ytani01/NixieTubeClock_IN-16/README.md

# Nixie Tube Clock: IN-16

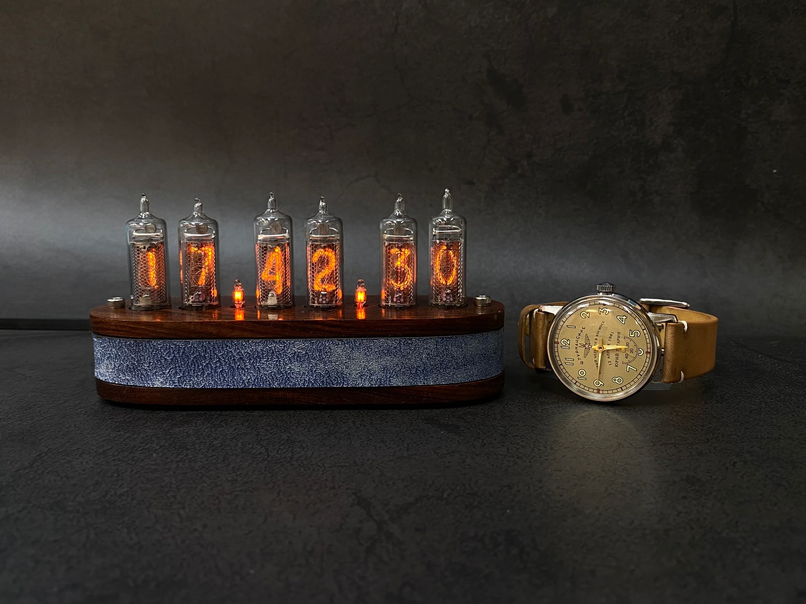
[picture p1: docs/figs/photo01.webp]


本物のニキシー管 IN-16 を使った置き時計です。
レトロな外界ですが、WiFi対応、OLED表示、エフェクトの切り替えなどの機能があります。

## ◆ 特徴

- WiFi対応で、インターネット(NTP)から常に正確な時刻を取得し、自動で時刻合わせします。
  - WiFiの設定は、スマートフォンから行います。
  - WiFiが使えないところでも、内部時計がバッテリーでバックアップされています。
- 底面に OLEDディスプレイがあり、WiFiの状態などを表示します。
- ニキシー管ならではの複数のエフェクトを切り替えることができます。
  (エフェクトなし、クロスフェード、フォグ(霧)、シャッフル)

### ◆ マニュアル

[マニュアル(PDF)](docs/Manual.pdf)

補足
- Reboot: [Button 0] + [Button 2]

## ◆ WiFi 設定

スマートフォンで、一旦、本機のアクセスポイントに接続してWiFiの設定を行います。

アクセスポイント名: NxClk_(固有のMACアドレス)

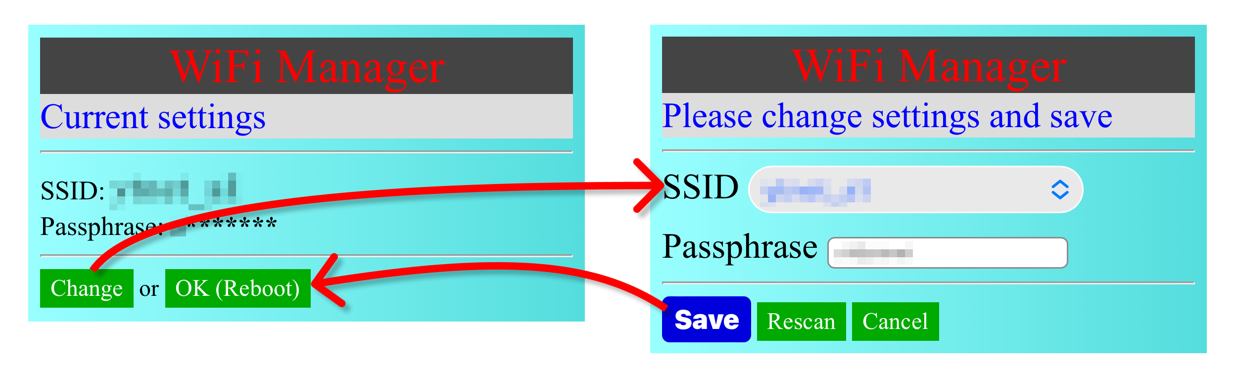
[picture p2: docs/figs/WiFi_Manager.png]
WiFi Manger


## ◆ OLED表示

### NTP
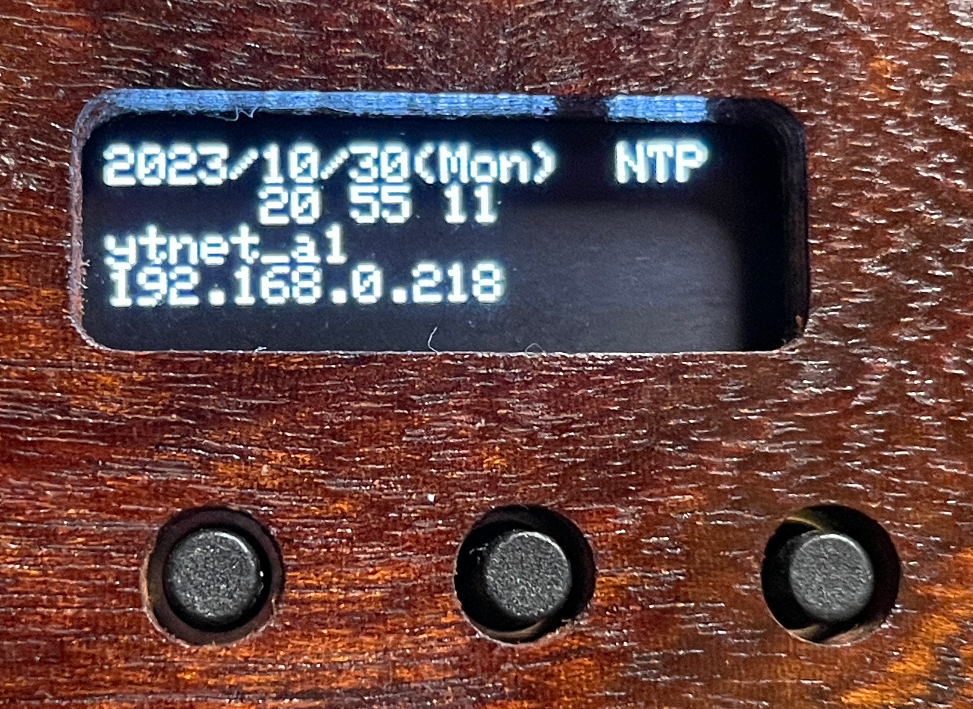
[picture p3: docs/figs/OLED-NTP.jpg]
OLED-NTP


### OLED: RTC
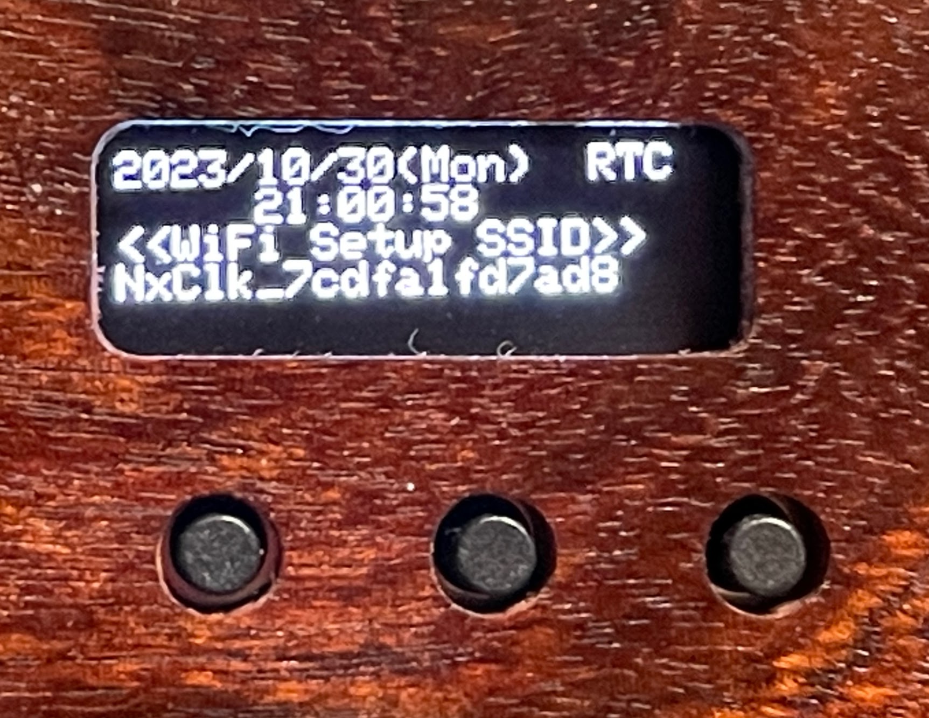
[picture p4: docs/figs/OLED-RTC.jpg]
OLED-RTC


## ◆ Effects

### Crossfade
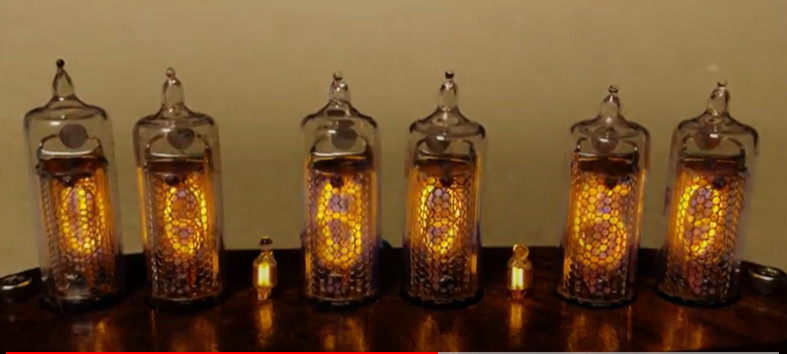
[picture p5: docs/movies/crossfade.jpg]
Crossfade (https://youtu.be/TvNmbtA_Buw?si=GQT42kCDqJkb_wn9)


### Fog
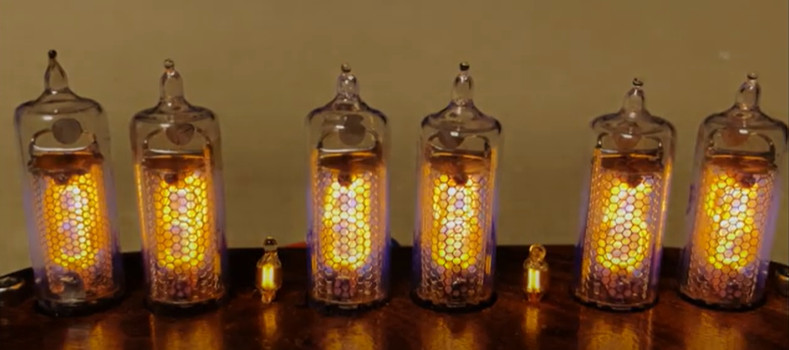
[picture p6: docs/movies/fog.jpg]
Fog (https://youtu.be/mSKaQIv3eQ8?si=7f47oo0_3DHgH0Qz)


### Shuffle
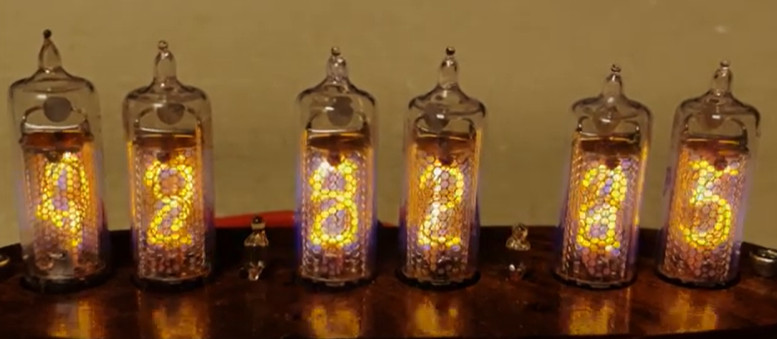
[picture p7: docs/movies/shuffle.jpg]
Shuffle (https://youtu.be/e5-Y6pX2xRI?si=2QsZdDAW-V6RgD0h)
