ytani01/NixieTubeClock_IN-16/references/fromTakao/IN-16_Nixie_Clock/drawing/IN-16_6digit_Nixie_Base.dxf

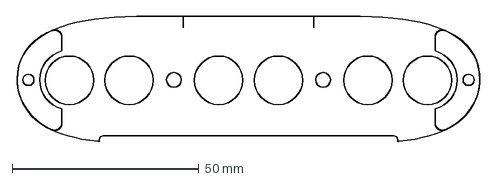
[picture p13: CAD file, 2023-10-02]
references/fromTakao/IN-16_Nixie_Clock/drawing/IN-16_6digit_Nixie_Base.dxf
124.5 x 33.5 mm
