ytani01/NixieTubeClock_IN-16/references/fromTakao/IN-16_Nixie_Clock/model/Spacer_3DPrint_Top_0817.stl

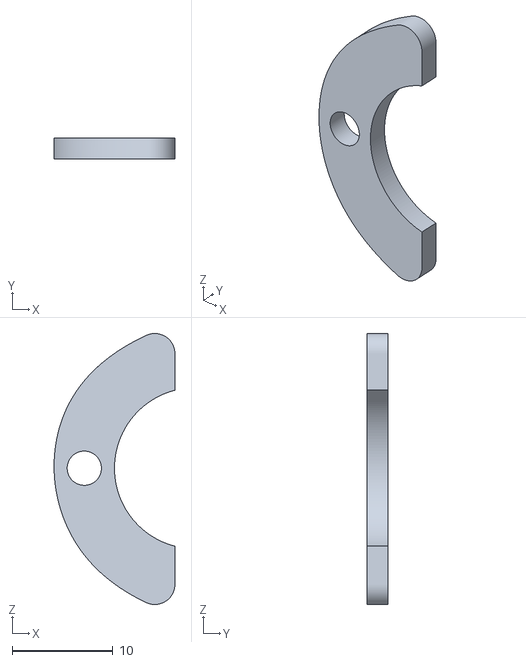
[picture p15: CAD file, 2023-10-02]
references/fromTakao/IN-16_Nixie_Clock/model/Spacer_3DPrint_Top_0817.stl
12.0 x 2.10 x 26.9
