ytani01/NixieTubeClock_IN-16/references/fromTakao/IN-16_Nixie_Clock/drawing/svg/Top_acrylic_0819.dxf

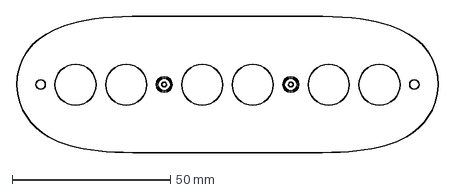
[picture p17: CAD file, 2023-10-02]
references/fromTakao/IN-16_Nixie_Clock/drawing/svg/Top_acrylic_0819.dxf
133.6 x 43.0 mm
