ytani01/NixieTubeClock_IN-16/references/fromTakao/IN-16_Nixie_Clock/drawing/Bottom_Rubber_Foot.dxf

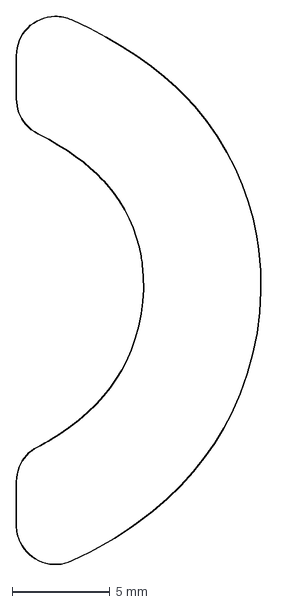
[picture p19: CAD file, 2023-10-02]
references/fromTakao/IN-16_Nixie_Clock/drawing/Bottom_Rubber_Foot.dxf
12.7 x 28.0 mm
