ytani01/NixieTubeClock_IN-16/references/fromTakao/IN-16_Nixie_Clock/model/Side_Wall_0817.stl

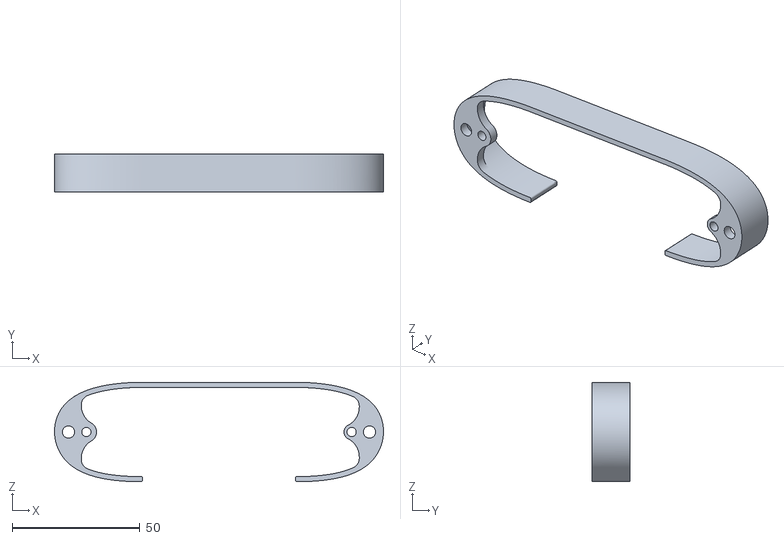
[picture p20: CAD file, 2023-10-02]
references/fromTakao/IN-16_Nixie_Clock/model/Side_Wall_0817.stl
129.0 x 15.0 x 39.0
