ytani01/NixieTubeClock_IN-16/references/fromTakao/IN-16_Nixie_Clock/drawing/IN-16_6digit_MCU_Base.dxf

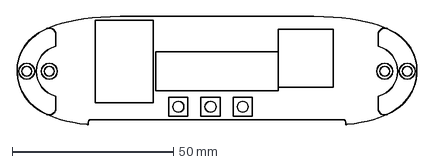
[picture p22: CAD file, 2023-10-02]
references/fromTakao/IN-16_Nixie_Clock/drawing/IN-16_6digit_MCU_Base.dxf
124.5 x 33.5 mm
