ytani01/NixieTubeClock_IN-16/references/fromTakao/IN-16_Nixie_Clock/drawing/header_placement_nixie.dxf

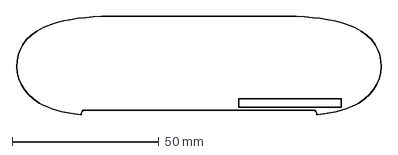
[picture p24: CAD file, 2023-10-02]
references/fromTakao/IN-16_Nixie_Clock/drawing/header_placement_nixie.dxf
124.5 x 33.5 mm
