ytani01/NixieTubeClock_IN-16/references/fromTakao/IN-16_Nixie_Clock/drawing/IN-16_6digit_PCB_drawing.dxf

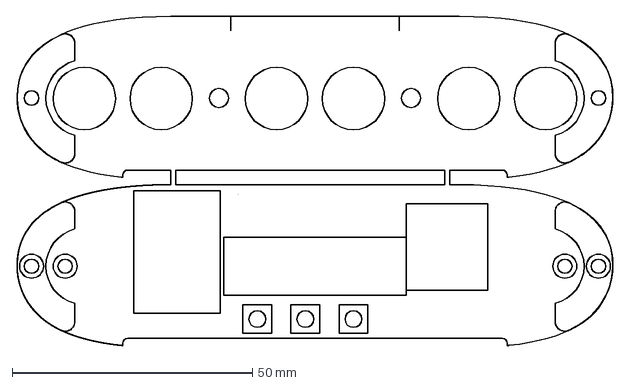
[picture p25: CAD file, 2023-10-02]
references/fromTakao/IN-16_Nixie_Clock/drawing/IN-16_6digit_PCB_drawing.dxf
124.5 x 68.5 mm
