ytani01/NixieTubeClock_IN-16/references/fromTakao/IN-16_Nixie_Clock/drawing/Bottom_Drawing_0827.dxf

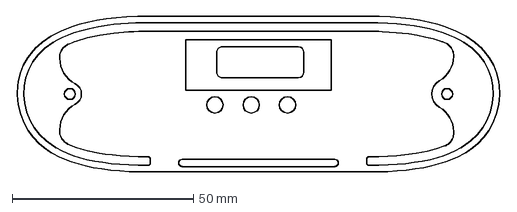
[picture p26: CAD file, 2023-10-02]
references/fromTakao/IN-16_Nixie_Clock/drawing/Bottom_Drawing_0827.dxf
133.6 x 43.0 mm
