ytani01/NixieTubeClock_IN-16/references/fromTakao/IN-16_Nixie_Clock/drawing/Side_wall_back.dxf

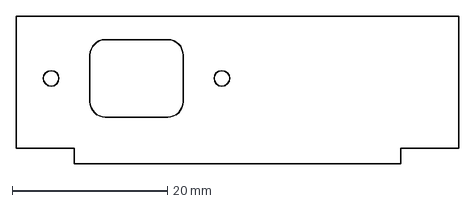
[picture p27: CAD file, 2023-10-02]
references/fromTakao/IN-16_Nixie_Clock/drawing/Side_wall_back.dxf
57.0 x 19.0 mm
