ytani01/NixieTubeClock_IN-16/references/fromTakao/IN-16_Nixie_Clock/drawing/Side_Wall_0824.stl

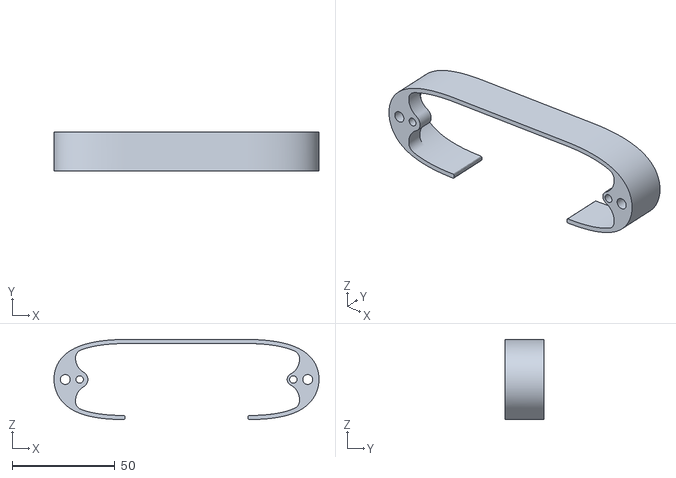
[picture p28: CAD file, 2023-10-02]
references/fromTakao/IN-16_Nixie_Clock/drawing/Side_Wall_0824.stl
129.0 x 19.0 x 39.0
