ytani01/NixieTubeClock_IN-16/references/fromTakao/IN-16_Nixie_Clock/drawing/lcd_typec_placement.dxf

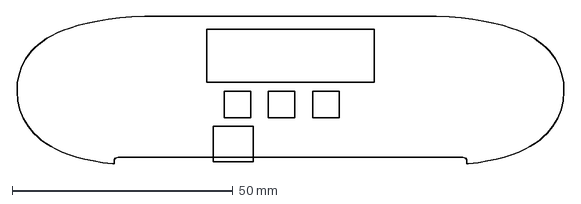
[picture p30: CAD file, 2023-10-02]
references/fromTakao/IN-16_Nixie_Clock/drawing/lcd_typec_placement.dxf
124.5 x 33.5 mm
