ytani01/NixieTubeClock_IN-16/references/fromTakao/IN-16_Nixie_Clock/drawing/Spacer_3DPrint_Mid_0824.stl

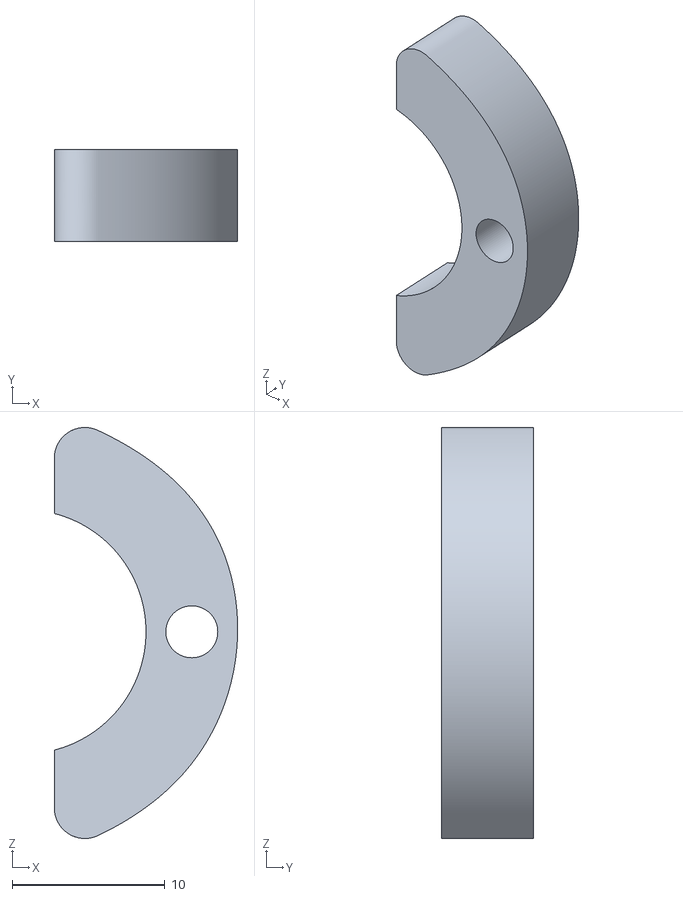
[picture p32: CAD file, 2023-10-02]
references/fromTakao/IN-16_Nixie_Clock/drawing/Spacer_3DPrint_Mid_0824.stl
12.0 x 6.00 x 26.9
