ytani01/NixieTubeClock_IN-16/(list of files, cad)

Other CAD files:
references/fromTakao/IN-16_Nixie_Clock/drawing/Spacer_3DPrint_Top_0824.stl
archives/references/fromTakao/IN-16_Nixie_Clock/drawing/Spacer_3DPrint_Top_0824.stl
