ytani01/NixieTubeClock_IN-16/tests/test02/README.md

# test01

- [ ] Serial: NG
- [x] log_i(): OK
- [x] buttons: OK
- [x] OLED: OK
- [ ] RTC
- [ ] WiFi
- [ ] Task
- [ ] Mode
- [ ] NixieTube
