ytani01/NixieTubeClock_IN-16/references/fromTakao/IN-16_Nixie_Clock/IN-16_Nixie_Clock.kicad_pcb

## KiCad design references/fromTakao/IN-16_Nixie_Clock/IN-16_Nixie_Clock.kicad_pcb (2023-10-02)

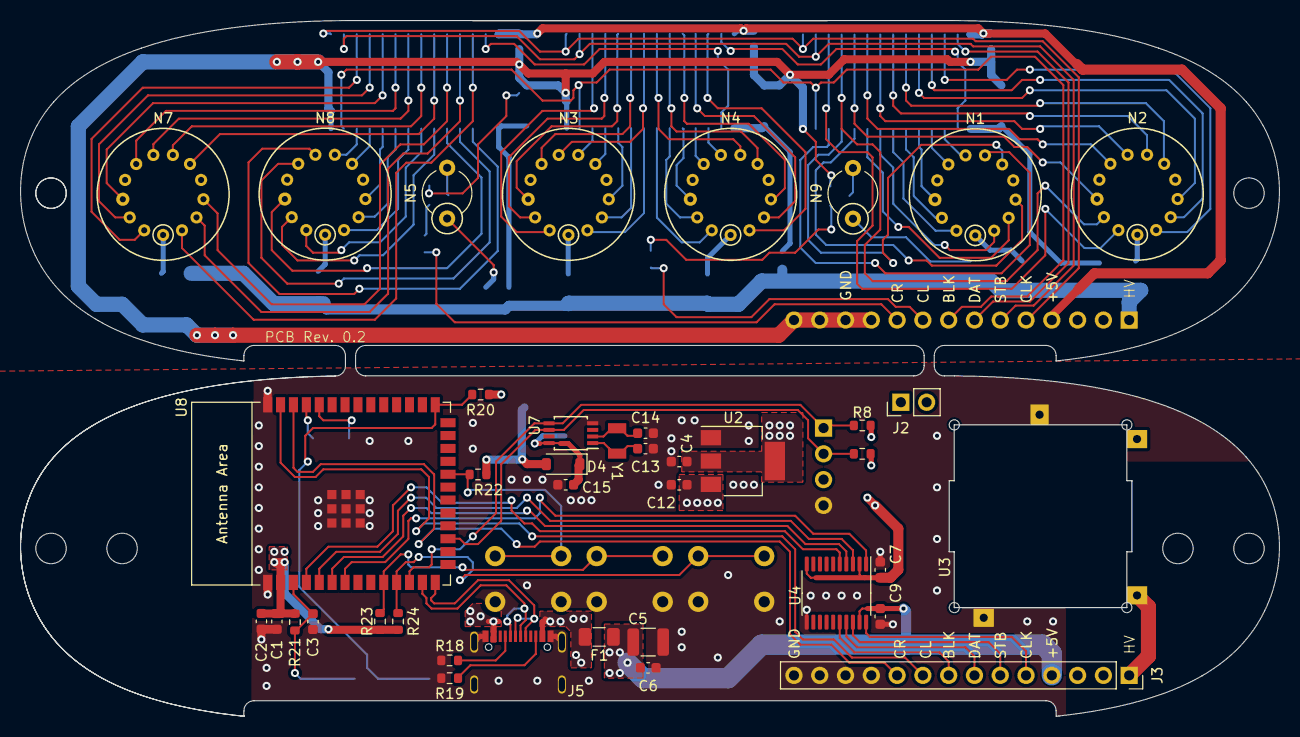
[picture p33: board IN-16_Nixie_Clock.kicad_pcb from above]

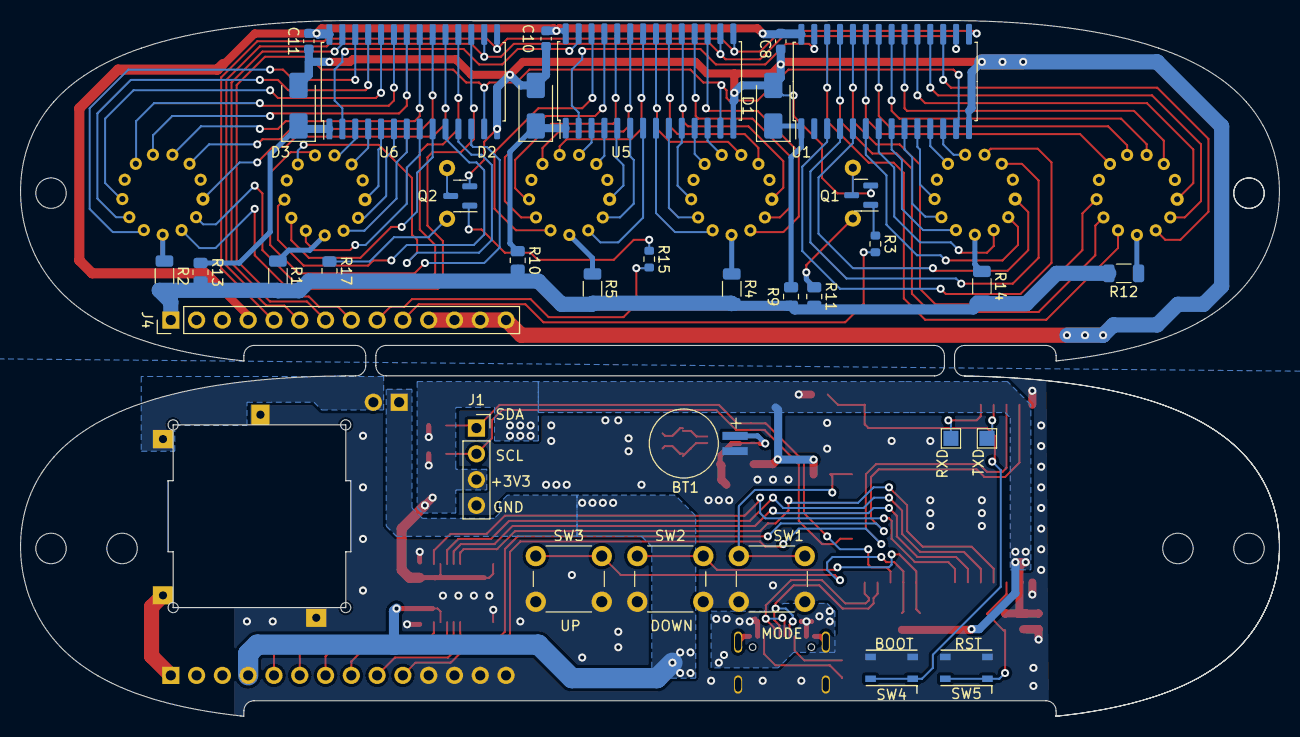
[picture p34: board IN-16_Nixie_Clock.kicad_pcb from below]

Board: 2 copper layers, 124.0 x 68.5 mm, 74 parts (34 on the bottom side), 117 nets.

Parts:
BT1: MS621FE FL11E
C1: 22uF; C_0603_1608Metric
C2, C3, C6, C7, C8, C9, C10, C11, C15: 100nF; C_0603_1608Metric
C4, C12: 10uF; C_0603_1608Metric
C5: 4.7uF; C_1210_3225Metric
C13, C14: 7pF; C_0603_1608Metric
D1, D2, D3: 82V; D_SMA
D4: B0540W-7-F; D_SOD-123
F1: Fuse; Fuse_1206_3216Metric
J1: Conn_LCD; PinSocket_1x04_P2.54mm_Vertical
J2: Jumper_HV_SW; PinHeader_1x02_P2.54mm_Vertical
J3: Conn_MCU_Base; PinSocket_1x14_P2.54mm_Vertical
J4: Conn_Nix_Base; PinHeader_1x14_P2.54mm_Vertical
J5: USB_C_Receptacle_USB2.0; GT-USB-7010AN
N1, N2, N3, N4, N7, N8: IN-16
N5, N9: INS-1; NE-2
Q1, Q2: MMBTA42; SOT-23
R1, R2, R4, R5, R12, R14: 22k_1210; R_1206_3216Metric
R3, R7, R8, R15, R20, R21: 10k; R_0603_1608Metric
R9, R10, R13: 100k_0805; R_0805_2012Metric
R11, R17: 220k_0805; R_0805_2012Metric
R18, R19: 5.1k; R_0603_1608Metric
R22, R23, R24: 1k; R_0603_1608Metric
SW1, SW2, SW3: SW_SPST; SW_PUSH_6mm_H4.3mm
SW4: SW_BOOT; SW_Tactile_SKRPACE010
SW5: SW_RST; SW_Tactile_SKRPACE010
TP1, TP2: TestPoint; TestPoint_Pad_1.5x1.5mm
U1, U5, U6: HV5812; SOIC-28W_7.5x17.9mm_P1.27mm
U2: AMS1117-3.3; SOT-223-3_TabPin2
U3: HV_Power_Supply; NCH8200HV_Sink
U4: TXS0108EPWR; TSSOP-20_4.4x6.5mm_P0.65mm
U7: PCF8563TS/5; TSSOP-8_3x3mm_P0.65mm
U8: ESP32-S3-WROOM-1
Y1: Crystal; Crystal_FC135

Connections:
+3V3: C1.1, C2.1, C4.1, C7.1, D4.2 (A), J1.3, R7.2, R8.2, R20.2, R21.2, R22.2, R23.2, R24.2, U2.2 (VO), U4.2 (VCCA), U4.10 (OE), U8.2 (3V3)
+5V: C5.1, C6.1, C9.1, C12.1, F1.1, J2.1, J3.4, U2.3 (VI), U4.19 (V)
+5V_C: C8.1, C10.1, C11.1, J4.4, U1.28 (VDD), U5.28 (VDD), U6.28 (VDD)
+HV: J3.1, U3.4 (VOUT)
+HV_C: J4.1, R1.2, R2.2, R4.2, R5.2, R9.2, R10.2, R11.2, R12.2, R13.2, R14.2, R17.2
/EN: C3.1, R21.1, SW5.1 (A), U8.3 (EN)
/IO0: R20.1, SW4.1 (A), U8.27 (GPIO0/BOOT)
/Nixie_Driver/AN_A0: N7.13 (K0), U1.17 (HVOUT10)
/Nixie_Driver/AN_A1: N7.2 (K1), U1.26 (HVOUT1)
/Nixie_Driver/AN_A2: N7.9 (K2), U1.20 (HVOUT7)
/Nixie_Driver/AN_A3: N7.4 (K3), U1.24 (HVOUT3)
/Nixie_Driver/AN_A4: N7.6 (K4), U1.23 (HVOUT4)
/Nixie_Driver/AN_A5: N7.7 (K5), U1.22 (HVOUT5)
/Nixie_Driver/AN_A6: N7.8 (K6), U1.21 (HVOUT6)
/Nixie_Driver/AN_A7: N7.3 (K7), U1.25 (HVOUT2)
/Nixie_Driver/AN_A8: N7.11 (K8), U1.19 (HVOUT8)
/Nixie_Driver/AN_A9: N7.12 (K9), U1.18 (HVOUT9)
/Nixie_Driver/AN_B0: N8.13 (K0), U1.7 (HVOUT16)
/Nixie_Driver/AN_B1: N8.2 (K1), U1.8 (HVOUT15)
/Nixie_Driver/AN_B2: N8.9 (K2), U1.4 (HVOUT19)
/Nixie_Driver/AN_B3: N8.4 (K3), U1.10 (HVOUT13)
/Nixie_Driver/AN_B4: N8.6 (K4), U1.11 (HVOUT12)
/Nixie_Driver/AN_B5: N8.7 (K5), U1.12 (HVOUT11)
/Nixie_Driver/AN_B6: N8.8 (K6), U1.3 (HVOUT20)
/Nixie_Driver/AN_B7: N8.3 (K7), U1.9 (HVOUT14)
/Nixie_Driver/AN_B8: N8.11 (K8), U1.5 (HVOUT18)
/Nixie_Driver/AN_B9: N8.12 (K9), U1.6 (HVOUT17)
/Nixie_Driver/AN_C0: N3.13 (K0), U5.17 (HVOUT10)
/Nixie_Driver/AN_C1: N3.2 (K1), U5.8 (HVOUT15)
/Nixie_Driver/AN_C2: N3.9 (K2), U5.20 (HVOUT7)
/Nixie_Driver/AN_C3: N3.4 (K3), U5.10 (HVOUT13)
/Nixie_Driver/AN_C4: N3.6 (K4), U5.11 (HVOUT12)
/Nixie_Driver/AN_C5: N3.7 (K5), U5.12 (HVOUT11)
/Nixie_Driver/AN_C6: N3.8 (K6), U5.21 (HVOUT6)
/Nixie_Driver/AN_C7: N3.3 (K7), U5.9 (HVOUT14)
/Nixie_Driver/AN_C8: N3.11 (K8), U5.19 (HVOUT8)
/Nixie_Driver/AN_C9: N3.12 (K9), U5.18 (HVOUT9)
/Nixie_Driver/AN_D0: N4.13 (K0), U5.7 (HVOUT16)
/Nixie_Driver/AN_D1: N4.2 (K1), U5.26 (HVOUT1)
/Nixie_Driver/AN_D2: N4.9 (K2), U5.4 (HVOUT19)
/Nixie_Driver/AN_D3: N4.4 (K3), U5.24 (HVOUT3)
/Nixie_Driver/AN_D4: N4.6 (K4), U5.23 (HVOUT4)
/Nixie_Driver/AN_D5: N4.7 (K5), U5.22 (HVOUT5)
/Nixie_Driver/AN_D6: N4.8 (K6), U5.3 (HVOUT20)
/Nixie_Driver/AN_D7: N4.3 (K7), U5.25 (HVOUT2)
/Nixie_Driver/AN_D8: N4.11 (K8), U5.5 (HVOUT18)
/Nixie_Driver/AN_D9: N4.12 (K9), U5.6 (HVOUT17)
/Nixie_Driver/AN_E0: N1.13 (K0), U6.7 (HVOUT16)
/Nixie_Driver/AN_E1: N1.2 (K1), U6.8 (HVOUT15)
/Nixie_Driver/AN_E2: N1.9 (K2), U6.4 (HVOUT19)
/Nixie_Driver/AN_E3: N1.4 (K3), U6.10 (HVOUT13)
/Nixie_Driver/AN_E4: N1.6 (K4), U6.11 (HVOUT12)
/Nixie_Driver/AN_E5: N1.7 (K5), U6.12 (HVOUT11)
/Nixie_Driver/AN_E6: N1.8 (K6), U6.3 (HVOUT20)
/Nixie_Driver/AN_E7: N1.3 (K7), U6.9 (HVOUT14)
/Nixie_Driver/AN_E8: N1.11 (K8), U6.5 (HVOUT18)
/Nixie_Driver/AN_E9: N1.12 (K9), U6.6 (HVOUT17)
/Nixie_Driver/AN_F0: N2.13 (K0), U6.17 (HVOUT10)
/Nixie_Driver/AN_F1: N2.2 (K1), U6.26 (HVOUT1)
/Nixie_Driver/AN_F2: N2.9 (K2), U6.20 (HVOUT7)
/Nixie_Driver/AN_F3: N2.4 (K3), U6.24 (HVOUT3)
/Nixie_Driver/AN_F4: N2.6 (K4), U6.23 (HVOUT4)
/Nixie_Driver/AN_F5: N2.7 (K5), U6.22 (HVOUT5)
/Nixie_Driver/AN_F6: N2.8 (K6), U6.21 (HVOUT6)
/Nixie_Driver/AN_F7: N2.3 (K7), U6.25 (HVOUT2)
/Nixie_Driver/AN_F8: N2.11 (K8), U6.19 (HVOUT8)
/Nixie_Driver/AN_F9: N2.12 (K9), U6.18 (HVOUT9)
/Nixie_Driver/BLANK: J3.8, U4.16 (B4)
/Nixie_Driver/BLANK_C: J4.8, U1.13 (BLANKING), U5.13 (BLANKING), U6.13 (BLANKING)
/Nixie_Driver/CLOCK: J3.5, U4.20 (B1)
/Nixie_Driver/CLOCK_C: J4.5, U1.15 (CLOCK), U5.15 (CLOCK), U6.15 (CLOCK)
/Nixie_Driver/COLON_L_C: J4.9, R15.2
/Nixie_Driver/COLON_R_C: J4.10, R3.2
/Nixie_Driver/DATA: J3.7, U4.17 (B3)
/Nixie_Driver/DATA_1: U5.27 (DI), U6.2 (DO)
/Nixie_Driver/DATA_2: U1.27 (DI), U5.2 (DO)
/Nixie_Driver/DATA_C: J4.7, U6.27 (DI)
/Nixie_Driver/STROBE: J3.6, U4.18 (B2)
/Nixie_Driver/STROBE_C: J4.6, U1.16 (STROBE), U5.16 (STROBE), U6.16 (STROBE)
/U0RXD: TP2.1, U8.36 (U0RXD/GPIO44/CLK_OUT2)
/U0TXD: TP1.1, U8.37 (U0TXD/GPIO43/CLK_OUT1)
/USBD+: J5.A6 (D+), J5.B6 (D+), U8.14 (GPIO20/U1CTS/ADC2_CH9/CLK_OUT1/USB_D+)
/USBD-: J5.A7 (D-), J5.B7 (D-), U8.13 (GPIO19/U1RTS/ADC2_CH8/CLK_OUT2/USB_D-)
/VBUS: F1.2, J5.A4B9 (VBUS), J5.B4A9 (VBUS)
BLANK_ESP32: U4.5 (A4), U8.4 (GPIO4/TOUCH4/ADC1_CH3)
CLOCK_ESP32: U4.1 (A1), U8.7 (GPIO7/TOUCH7/ADC1_CH6)
COLON_L: J3.9, U8.39 (GPIO1/TOUCH1/ADC1_CH0)
COLON_R: J3.10, U8.38 (GPIO2/TOUCH2/ADC1_CH1)
DATA_ESP32: U4.4 (A3), U8.6 (GPIO6/TOUCH6/ADC1_CH5)
GND: BT1.2 (-), C1.2, C2.2, C3.2, C4.2, C5.2, C6.2, C7.2, C8.2, C9.2, C10.2, C11.2, C12.2, C13.2, C14.2, C15.1, D1.2 (A), D2.2 (A), D3.2 (A), J1.4, J3.11, J3.12, J3.13, J3.14, J4.11, J4.12, J4.13, J4.14, J5.A1B12 (GND), J5.B1A12 (GND), J5.S1 (SHIELD), Q1.2 (E), Q2.2 (E), R18.1, R19.1, SW1.2 (B), SW2.2 (B), SW3.2 (B), SW4.2 (B), SW5.2 (B), U1.14 (GND), U2.1 (GND), U3.2 (GND), U3.3 (GND), U4.11 (GND), U5.14 (GND), U6.14 (GND), U7.4 (VSS), U8.1 (GND), U8.40 (GND), U8.41 (GND)
unnamed: BT1.1 (+), C15.2, D4.1 (K), U7.8 (VDD)
unnamed: D1.1 (K), R9.1, U1.1 (VPP)
unnamed: D2.1 (K), R10.1, U5.1 (VPP)
unnamed: D3.1 (K), R13.1, U6.1 (VPP)
unnamed: J2.2, U3.1 (VIN)
unnamed: J5.A5 (CC1), R18.2
unnamed: J5.B5 (CC2), R19.2
unnamed: N1.1 (A), R1.1
unnamed: N2.1 (A), R2.1
unnamed: N3.1 (A), R4.1
unnamed: N4.1 (A), R5.1
unnamed: N5.A, R11.1
unnamed: N7.1 (A), R12.1
unnamed: N8.1 (A), R14.1
unnamed: N9.A, R17.1
unnamed: Q1.1 (B), R3.1
unnamed: N5.C, Q1.3 (C)
unnamed: Q2.1 (B), R15.1
unnamed: N9.C, Q2.3 (C)
unnamed: C13.1, U7.1 (OSCI), Y1.2
unnamed: C14.1, U7.2 (OSCO), Y1.1
SCL: J1.2, R8.1, U7.6 (SCL), U8.17 (GPIO9/TOUCH9/ADC1_CH8/FSPIHD/SUBSPIHD)
SDA: J1.1, R7.1, U7.5 (SDA), U8.12 (GPIO8/TOUCH8/ADC1_CH7/SUBSPICS1)
STROBE_ESP32: U4.3 (A2), U8.5 (GPIO5/TOUCH5/ADC1_CH4)
SW_0: R22.1, SW1.1 (A), U8.22 (GPIO14/TOUCH14/ADC2_CH3/FSPIWP/FSPIDQS/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)
SW_1: R23.1, SW2.1 (A), U8.10 (GPIO17/U1TXD/ADC2_CH6)
SW_2: R24.1, SW3.1 (A), U8.11 (GPIO18/U1RXD/ADC2_CH7/CLK_OUT3)
