ytani01/NixieTubeClock_IN-16/references/fromTakao/IN-16_Nixie_Clock/code/NixieTubeClock/ModeClock.cpp

/**
 * Copyright (c) 2021 Yoichi Tanibayashi
 */
#include "ModeClock.h"

static const unsigned int CL_FADE_OFF = 0;
static const unsigned int CL_FADE_IN  = 1;
static const unsigned int CL_FADE_OUT = 2;
int colon_fade_mode[NIXIE_COLON_N] = {CL_FADE_OFF, CL_FADE_OFF};

static const unsigned long CL_FADE_TICK0 = 20;
static const unsigned long CL_FADE_TICK1 = 120;
static unsigned long cFadeTick = CL_FADE_TICK0;

extern boolean wifiActive;

static DateTime prev_dt = DateTime(2000,1,1,0,0,0,0);

#include <Adafruit_NeoPixel.h>
extern Adafruit_NeoPixel   Pixels;
static const uint8_t       PIXEL_N = 6;
static const int           PIXEL_BL = 255;
static const unsigned long PixelCol[] =
  {0x000000, 0xffffff, 0x0000ff, 0x0000ff};
static boolean pixel_on = false;
static boolean prev_pixel_on = pixel_on;

/**
 *
 */
ModeClock::ModeClock(NixieArray *nxa): ModeBase::ModeBase(nxa,
                                                          "Clock",
                                                          ModeClock::TICK_MS) {
} // ModeClock::ModeClock()

/**
 *
 */
void ModeClock::init(unsigned long start_ms, DateTime& now,
                     int init_val[NIXIE_NUM_N]) {
  ModeBase::init(start_ms, now, init_val);
  this->mode_start_ms = millis();
  Serial.printf("ModeClock::init> mode_start_ms=%ld, stat=0x%X\n",
                this->mode_start_ms, (int)this->stat);

  Nx->brightness = this->brightness;
}

/**
 *
 */
stat_t ModeClock::loop(unsigned long cur_ms, DateTime& now) {
  char disp_str[6 + 1];
  int  prev_num[NIXIE_NUM_N];
  static unsigned long prev_mode = MODE_NULL;

  if ( ModeBase::loop(cur_ms, now) == STAT_SKIP ) {
    return STAT_SKIP;
  }

  if ( this->stat != STAT_NONE && this->stat != STAT_DONE ) {
    Serial.printf("ModeClock::loop> stat=0x%X\n", (int)this->stat);
    return this->stat;
  }

  if ( pixel_on != prev_pixel_on ) {
    Serial.printf("ModeClock::loop> pixel_on=%d\n", pixel_on);
    prev_pixel_on = pixel_on;

    if ( pixel_on ) {
      for (int i=0; i < PIXEL_N; i++) {
        Pixels.setPixelColor(i, PixelCol[this->mode]);
      } // for(i)
    } else {
      Pixels.clear();
    } // if (pixel_on)
    Pixels.show();
    prev_mode = this->mode;
  } // if
  
  if ( pixel_on ) {
    if ( this->mode != prev_mode ) {
      for (int i=0; i < PIXEL_N; i++) {
        Pixels.setPixelColor(i, PixelCol[this->mode]);
      } // for(i)
      Pixels.show();
      prev_mode = this->mode;
    } // if
  } //if
  
  switch ( this->mode ) {
  case ModeClock::MODE_HMS:
    sprintf(disp_str, "%02d%02d%02d", now.hour(), now.minute(), now.second());
    break;

  case ModeClock::MODE_DHM:
    sprintf(disp_str, "%02d%02d%02d", now.day(), now.hour(), now.minute());
    break;

  case ModeClock::MODE_YMD:
    if ( cur_ms - this->mode_start_ms > DISP_DATE_MS ) {
      this->change_mode(MODE_HMS);

      this->stat = STAT_DONE;
      return this->stat;
    }
    sprintf(disp_str, "%02d%02d%02d",
            now.year() % 100, now.month(), now.day());
    break;

  case ModeClock::MODE_MDH:
    if ( cur_ms - this->mode_start_ms > DISP_DATE_MS ) {
      this->change_mode(MODE_HMS);

      this->stat = STAT_DONE;
      return this->stat;
    }
    sprintf(disp_str, "%02d%02d%02d",
            now.month(), now.day(), now.hour());
    break;

  default:
    sprintf(disp_str, "%02d%02d%02d",
            now.hour(), now.minute(), now.second());
    break;
  } // switch (mode)

  for (int i=0; i < NIXIE_NUM_N; i++) {
    prev_num[i] = this->_num[i];
    this->_num[i] = int(disp_str[i] - '0');
    if ( this->_num[i] != prev_num[i] ) {
      NxNum(i).xfade_start(cur_ms, FADE_TICK_MS,
                           this->_num[i], prev_num[i]);
    }
  } // for(NUM)

  for (int i=0; i < NIXIE_COLON_N; i++) {
    if ( prev_dt.second() != now.second() ) {
      NxColEl(i, NIXIE_COLON_DOT_DOWN).set_brightness(Nx->brightness);
      if ( this->mode != ModeClock::MODE_YMD || wifiActive ) {
        NxCol(i).fadeout_start(cur_ms, cFadeTick,
                               NIXIE_COLON_DOT_DOWN);
        colon_fade_mode[i] = CL_FADE_OUT;
        continue;
      }
    }

    if (NxCol(i).effect_is_active()) {
      continue;
    }

    // effect is inactive
    if(colon_fade_mode[i] == CL_FADE_OUT) {
      NxCol(i).fadein_start(cur_ms, cFadeTick, NIXIE_COLON_DOT_DOWN);
      colon_fade_mode[i] = CL_FADE_IN;
    }
  } // for(COLON)
  prev_dt = DateTime(now);

  this->stat = STAT_DONE;
  return this->stat;
} // ModeClock::loop()

void ModeClock::change_mode(unsigned long mode=ModeClock::MODE_NULL) {
  Serial.printf("ModeClock::change_mode(%ld)> ", this->mode);

  if ( mode != MODE_NULL ) {
    this->mode = mode;
  } else {
    switch ( this->mode ) {
    case MODE_HMS:
      this->mode = MODE_YMD;
      break;
    case MODE_DHM:
      this->mode = MODE_YMD;
      break;
    case MODE_YMD:
      this->mode = MODE_HMS;
      break;
    default:
      this->mode = MODE_HMS;
      break;
    } // switch(mode)
  }
  this->mode_start_ms = millis();
  Serial.printf("mode=%ld, mode_start_ms=%ld\n", this->mode, this->mode_start_ms);
}

void ModeClock::btn_intr_hdr(unsigned long cur_ms, Button *btn) {
} // ModeClock::btn_intr_hdr()

void ModeClock::btn_loop_hdr(unsigned long cur_ms, Button *btn) {
  boolean      flag = false;
  unsigned int bl = Nx->brightness;
  
  // BTN0 or BTN1 or BTN2
  if ( btn->get_name() == "BTN0" ) {
    // BTN0
    if ( btn->is_long_pressed() && ! btn->is_repeated() ) {
      this->stat = ModeBase::STAT_NEXT_MODE;
      Serial.printf("ModeClock::btn_loop_hdr> stat=0x%X\n", (int)this->stat);
      return;
    }
    return;
  }

  // BTN1 or BTN2
  if ( btn->get_name() == "BTN1" ) {
    // BTN1
    if ( btn->get_click_count() >= 1 ) {
      this->change_mode();
    }
    return;
  }

  // BTN2
  if ( btn->get_click_count() == 0 ) {
    return;
  }
  
  if ( btn->get_click_count() == 1 ) {
    bl /= 2;
    if (bl < BRIGHTNESS_MIN || bl > BRIGHTNESS_RESOLUTION) {
      bl = BRIGHTNESS_RESOLUTION;
    }
  
    Nx->brightness = bl;
    this->brightness = bl;
    Serial.printf("ModeClock::btn_loop_hdr> Nx->brightness=%d\n",
                  Nx->brightness);
    for (int i=0; i < NIXIE_NUM_N; i++) {
      NxNumEl(i, this->_num[i]).set_brightness(bl);
    } // for(NUM)
  
    for (int i=0; i < NIXIE_COLON_N; i++) {
      NxColEl(i, NIXIE_COLON_DOT_DOWN).set_brightness(bl);
    } // for(COLON)

    return;
  } // if

  // BTN2 and click_count > 1
  pixel_on = !pixel_on;
  Serial.printf("ModeClock::btn_loop_hdr> pixel_on=%d\n", pixel_on);
  
} // ModeClock::btn_loop_hdr()
