ytani01/NixieTubeClock_IN-16/src/commonlib.cpp

/**
 * Copyright (c) 2023 Yoichi Tanibayashi
 */
#include "commonlib.h"

// ===========================================================================
// System memory
// ===========================================================================
/**
 * @brief check memory leak
 */
bool chk_mem(int sec, int unit) {
  static uint32_t prev_ms = 0;
  static uint32_t prev_heap_size = 0;
  static uint32_t prev_stack_size = 0;

  uint32_t ms = millis();
  uint32_t heap_size = esp_get_free_heap_size() / 1000;
  uint32_t stack_size = uxTaskGetStackHighWaterMark(NULL);

  if ( ms - prev_ms >= sec * 1000 ||
       heap_size / unit * unit != prev_heap_size / unit * unit ||
       stack_size != prev_stack_size ) {

    log_i("===== heap_size = %uk, stack_size = %u",
          heap_size, stack_size);

    prev_ms = ms;
    prev_heap_size = heap_size;
    prev_stack_size = stack_size;
    return true;
  }
  return false;
} // chk_memleak()

/**
 *
 */
std::deque<uint32_t> chk_heap(size_t q_size) {
  static std::deque<uint32_t> hist;

  log_v("heap.size():%d", hist.size());

  if ( q_size > 0 ) {
    while ( hist.size() >= q_size ) {
      hist.pop_back();
    }
  }

  hist.push_front(esp_get_free_heap_size());
  log_v("heap.size():%d", hist.size());

  return hist;
} // chk_heap()

// ===========================================================================
// MAC address
// ===========================================================================
/**
 * get MAC address String
 */
std::string get_mac_addr_string() {
  uint8_t mac_addr[6];
  char mac_str[13];

  esp_read_mac(mac_addr, ESP_MAC_WIFI_STA);
  sprintf(mac_str, "%02x%02x%02x%02x%02x%02x",
          mac_addr[0], mac_addr[1], mac_addr[2],
          mac_addr[3], mac_addr[4], mac_addr[5]);
  //log_v("MacAddr=%s", mac_str);

  return std::string(mac_str);
} // get_mac_addr_string()

// ===========================================================================
// date time
// ===========================================================================
static String WDayStr[] = {"Sun", "Mon", "Tue", "Wed", "Thu", "Fri", "Sat"};

/**
 * @brief struct tm --> DateTime
 */
DateTime tm2datetime(struct tm *tm) {
  return DateTime(tm->tm_year + 1900,
                  tm->tm_mon + 1,
                  tm->tm_mday,
                  tm->tm_hour, tm->tm_min, tm->tm_sec);
} // tm2datetime()

/**
 * @brief  struct tm --> string
 *
 * buf が static なので危険！
 * tm2string() を推奨
 */
static char *tm2str(struct tm *tm, const char fmt[]) {
  static char buf[DATETIME_STR_LEN];

  int res = strftime(buf, sizeof(buf), fmt, tm);

  return (char *)buf;
} // tm2str()

/**
 *
 */
std::string tm2string(struct tm *tm, const char fmt[]) {
  return std::string(tm2str(tm, fmt));
}

/**
 * @brief  DateTime --> string
 */
std::string datetime2string(DateTime *dt, const char *fmt) {
  static struct tm tm;
  tm.tm_year = dt->year() - 1900;
  tm.tm_mon = dt->month() - 1;
  tm.tm_mday = dt->day();
  tm.tm_wday = dt->dayOfTheWeek();
  tm.tm_hour = dt->hour();
  tm.tm_min = dt->minute();
  tm.tm_sec = dt->second();
  
  return tm2string(&tm, fmt);
} // datetime2str()

/**
 *
 */
bool is_leap_year(int year) {
  return (year % 4 == 0 && year % 100 != 0) || (year % 400 == 0);
} // isLeapYear()

/**
 *
 */
int last_day(int year, int month) {
  if (month == 4 || month == 6 || month == 9 || month == 11) {
    return 30;
  }
  if (month == 2) {
    return is_leap_year(year) ? 29 : 28;
  }
  return 31;
} // getLastDayOfMonth()

/**
 *
 */
std::string ms2string(unsigned long ms) {
  if ( ms < 1000 ) {
    return std::to_string(ms) + "ms";
  }

  unsigned long sec = ms / 1000;
  ms %= 1000;

  char ms_str[5];
  sprintf(ms_str, ".%03d", ms);

  if ( sec < 60 ) {
    return std::to_string(sec)
      + std::string(ms_str);
  }

  // sec >= 60

  unsigned long minute = sec / 60;
  sec %= 60;

  char sec_str[4];
  sprintf(sec_str, ":%02d", sec);
  
  if ( minute < 60 ) {
    return std::to_string(minute)
      + std::string(sec_str)
      + std::string(ms_str);
  }

  // minute >= 60

  unsigned long hour = minute / 60;
  minute %= 60;

  char minute_str[4];
  sprintf(minute_str, ":%02d", minute);

  if ( hour < 24 ) {
    return std::to_string(hour)
      + std::string(minute_str)
      + std::string(sec_str)
      + std::string(ms_str);
  }

  // hour >= 24

  unsigned long day = hour / 24;
  hour %= 24;

  char hour_str[4];
  sprintf(hour_str, "_%02d", hour);
  
  return std::to_string(day)
    + std::string(hour_str)
    + std::string(minute_str)
    + std::string(sec_str)
    + std::string(ms_str);
} // ms2string()
