ytani01/NixieTubeClock_IN-16/references/fromTakao/IN-16_Nixie_Clock/code/NixieTubeClock/NixieTube.cpp

/**
 * (c) 2021 Yoichi Tanibayashi
 */
#include "NixieTube.h"

void NixieTube::setup(int element_n, uint8_t *pin) {
  this->element_n = element_n;
  this->element = new NixieElement[this->element_n];
  for (int d=0; d < element_n; d++) {
    this->element[d].setup(pin[d]);
  } // for (d)
  this->_ef = (Effect *)NULL;
} // NixieTube::setup()

void NixieTube::loop(unsigned long cur_ms) {
  if ( this->_ef == (Effect *)NULL ) {
    return;
  }
  if ( ! this->_ef->is_active() ) {
    delete this->_ef;
    this->_ef = (Effect *)NULL;
    return;
  }
  // Effect is active
  this->_ef->loop(cur_ms);
} // NixieTube::loop()

Effect *NixieTube::init_effect(effect_id_t eid) {
  if ( this->_ef != (Effect *)NULL ) {
    if ( this->_ef->is_active() ) {
      this->_ef->end();
    }
    delete this->_ef;
    this->_ef = (Effect *)NULL;
  }

  switch (eid) {
  case EFFECT_ONLY:     return new EffectOnly(this->element, this->element_n);
  case EFFECT_FADEIN:   return new EffectFadeIn(this->element, this->element_n);
  case EFFECT_FADEOUT:  return new EffectFadeOut(this->element, this->element_n);
  case EFFECT_XFADE:    return new EffectXFade(this->element, this->element_n);
  case EFFECT_SHUFFLE:  return new EffectShuffle(this->element, this->element_n);
  case EFFECT_BLINK:    return new EffectBlink(this->element, this->element_n);
  case EFFECT_RANDOM_ONOFF:    return new EffectRandomOnOff(this->element, this->element_n);
  default:
    Serial.println("ERROR: eid = " + String(eid));
    return (Effect *)NULL;
  }
} // NixieTube::init_effect()

void NixieTube::end_effect() {
  if ( this->_ef == (Effect *)NULL ) {
    return;
  }
  if ( this->_ef->is_active() ) {
    this->_ef->end();
  }
  delete this->_ef;
  this->_ef = (Effect *)NULL;
} // NixieTube::end_effect()

boolean NixieTube::effect_is_active() {
  return this->_ef;
} // NixieTube::effect_is_active()

void NixieTube::fadein_start(unsigned long start_ms,
                             unsigned long tick_ms,
                             int element) {
  this->_ef = this->init_effect(EFFECT_FADEIN);
  this->_ef->start(start_ms, tick_ms, element);
} // NixieTube::fadein_start()

void NixieTube::fadeout_start(unsigned long start_ms,
                              unsigned long tick_ms,
                              int element) {
  this->_ef = this->init_effect(EFFECT_FADEOUT);
  this->_ef->start(start_ms, tick_ms, element);
} // NixieTube::fadeout_start()

void NixieTube::xfade_start(unsigned long start_ms,
                            unsigned long tick_ms,
                            int el_in, int el_out) {
  this->_ef = this->init_effect(EFFECT_XFADE);
  this->_ef->start(start_ms, tick_ms, el_in, el_out);
} // NixieTube::xfade_start()

void NixieTube::shuffle_start(unsigned long start_ms,
                              unsigned long tick_ms,
                              int n, int el) {
  this->_ef = this->init_effect(EFFECT_SHUFFLE);
  this->_ef->start(start_ms, tick_ms, n, el);
} // NixieTube::shuffle_start()

void NixieTube::blink_start(unsigned long start_ms,
                            unsigned long tick_ms) {
  this->_ef = this->init_effect(EFFECT_BLINK);
  this->_ef->start(start_ms, tick_ms);
} // NixieTube::blink_start()

void NixieTube::randomOnOff_start(unsigned long start_ms,
                                  unsigned long tick_ms,
                                  int el) {
  this->_ef = this->init_effect(EFFECT_RANDOM_ONOFF);
  this->_ef->start(start_ms, tick_ms, el);
}
