ytani01/NixieTubeClock_IN-16/src/Mode_Reboot.cpp

/**
 * Copyright (c) 2023 Yoichi Tanibayashi
 */
#include "Mode_Reboot.h"

/**
 *
 */
Mode_Reboot::Mode_Reboot(unsigned long interval): Mode() {
  this->interval = interval;
} // Mode_Reboot::Mode_Reboot()

/** virtual
 *
 */
void Mode_Reboot::enter() {
  log_i("enter mode: %s", this->name.c_str());

  this->start_ms = millis();

  Nxa->set_string(VersionString.c_str());
  unsigned long ms = 80 * (BRIGHTNESS_RESOLUTION / Nxa->brightness());
  Nxa->set_string("        ", NXT_EFFECT_XFADE, ms);
  
  Disp->fillRect(0, 0, DISPLAY_W, DISPLAY_H, BLACK);
  Disp->display();
} // Mode_Reboot::enter()

/** virtual
 *
 */
void Mode_Reboot::exit() {
  log_i("");
  Nxa->end_all_effect();
  this->start_ms = 0;
} // Mode_Reboot::exit()

/** virtual
 *
 */
void Mode_Reboot::loop() {
  unsigned long cur_ms = millis();
  struct tm *tm = SysClock::now_tm();
  struct timeval *tv = SysClock::now_timeval();

  //
  // check interval
  //
  if ( cur_ms - this->start_ms > this->interval ) {
    log_i("done");
    Flag_LoopRunning = false;

    ESP.restart();
    return;
  }

  //
  // Disp
  //
  char *fmt_date, *fmt_time;

  fmt_date = (char *)"%Y/%m/%d(%a)";
  if ( tm->tm_sec % 2 == 0 ) {
    fmt_time =(char *)"%H:%M:%S";
  } else {
    fmt_time =(char *)"%H %M %S";
  }

  Disp->fillRect(0, 0, DISPLAY_W, DISPLAY_H, BLACK);
  Disp->setCursor(0, 0);
  Disp->setTextSize(1);

  Disp->setTextColor(WHITE, BLACK);
  Disp->printf("%s\n", tm2string(tm, fmt_date).c_str());
  Disp->printf("     %s\n", tm2string(tm, fmt_time).c_str());
  Disp->printf("reboot .. ");
  Mode::disp_spin(100);

  Disp->setCursor(0, DISPLAY_H - DISPLAY_CH_H);
  Disp->setTextSize(1);
  Disp->printf("%s", get_mac_addr_string().c_str());

  Disp->display();

  delayOrChangeMode(50);
} // Mode_Reboot::loop()

/**
 *
 */
void Mode_Reboot::cbBtn(const ButtonInfo_t& bi,
                       const std::map<std::string, ButtonInfo_t>& btn_info) {
  log_d("%s", Button::info2String(bi).c_str());

  if ( String(bi.name) == "Btn0" ) {
    if ( bi.value == Button::ON ) {
      WiFi.disconnect();
      TaskWifiMgr->mode = WIFI_MGR_MODE_AP;
    }
  }
} // Mode_Reboot::cbBtn()
