ytani01/NixieTubeClock_IN-16/src/Mode_Reboot.h

/**
 * Copyright (c) 2023 Yoichi Tanibayashi
 */
#ifndef _MODE_REBOOT_H_
#define _MODE_REBOOT_H_

#include "Mode.h"

extern std::string VersionString;

class Mode_Reboot: public Mode {
 public:
  static const unsigned long BOOT_INTERVAL_MS = 2000;  // ms

  unsigned long interval = BOOT_INTERVAL_MS;
  unsigned long start_ms = 0;

  Mode_Reboot(unsigned long interval=BOOT_INTERVAL_MS);

  virtual void enter();
  virtual void exit();
  virtual void loop();

  virtual void cbBtn(const ButtonInfo_t& bi,
                     const std::map<std::string, ButtonInfo_t>& btn_info);
};

#endif // _MODE_REBOOT_H_
