ytani01/NixieTubeClock_IN-16/src/Task_NixieTubeArray.cpp

/**
 * Copyright (c) 2023 Yoichi Tanibayashi
 */
#include "Task_NixieTubeArray.h"

/** static variables
 *
 */
int Task_NixieTubeArray::INIT_VAL[] = {0, 0, 0, 0, 0, 0};

/** constructor
 *
 */
Task_NixieTubeArray::Task_NixieTubeArray(Nixie_TubeArray *nta,
                                         brightness_t brightness,
                                         int *init_val,
                                         uint32_t stack_size,
                                         UBaseType_t priority,
                                         UBaseType_t core)
  : Task(__CLASS_NAME__, stack_size, priority, core) {

  this->_nta = nta;
  this->_nta->set_brightness(brightness);

  if ( init_val == NULL ) {
    this->init_val = (int *)Task_NixieTubeArray::INIT_VAL;
  } else {
    this->init_val = init_val;
  }

} // Task_NixieTubeArray::Task_NixieTubeArray()

/**
 * 
 */
void Task_NixieTubeArray::setup() {
  log_d("%s", this->conf.name.c_str());

  Nta->set_string("        ");
} // Task_NixieTubeArray::setup()

/**
 *
 */
void Task_NixieTubeArray::loop() {
#if 0
  chk_mem(60, 100);
#endif

  if ( ! enable_update ) {
    return;
  }

  unsigned long cur_ms = millis();
  
  Nta->display(cur_ms);

  delayMicroseconds(1);
} // Task_NixieTubeArray::loop()
