ytani01/NixieTubeClock_IN-16/src/Task_NixieTubeArray.h

/**
 * Copyright (c) 2023 Yoichi Tanibayashi
 */
#ifndef _TASK_NIXIETUBEARRAY_H_
#define _TASK_NIXIETUBEARRAY_H_

#include "Task.h"
#include "Nixie.h"
#include "Nixie_TubeArray.h"

/**
 *
 */
class Task_NixieTubeArray
  : public Task {
public:
  static const uint32_t STACK_SIZE = 4 * 1024;
  static const UBaseType_t PRIORITY = 4;
  static const UBaseType_t CORE = APP_CPU_NUM;

  static int INIT_VAL[];

  bool enable_update = true;

  Task_NixieTubeArray(Nixie_TubeArray *nta,
                      brightness_t brightness = 0, // default: load conf file
                      int *init_val=NULL,
                      uint32_t stack_size=STACK_SIZE,
                      UBaseType_t priority=PRIORITY,
                      UBaseType_t core=CORE);

protected:
  virtual void setup();
  virtual void loop();

  Nixie_TubeArray *_nta;
  int *init_val;
}; // class Task_NixieTubeArray

#endif // _TASK_NIXIETUBEARRAY_H_
