ytani01/NixieTubeClock_IN-16/src/ConfFile.cpp

/**
 * Copyright (c) 2023 Yoichi Tanibayashi
 */
#include "ConfFile.h"

/** constructor
 *
 */
ConfFile::ConfFile(String file_name) {
  this->file_name = file_name;

  if ( ! SPIFFS.begin(true) ) {
    log_e("%s: SPIFFS mount failed", this->file_name.c_str());
  }
} // ConfFile::ConfFile()

/** virtual
 *
 */
int ConfFile::load() {
  // test code
  if ( ! this->open_read() ) {
    return -1;
  }

  while ( int fsize = this->file.available() ) {
    String line = this->read_line();
    log_d("%d: %d: \"%s\"", this->line_count, fsize, line.c_str());
  }
  this->file.close();

  return this->line_count;
} // ConfFile::load()

/** virtual
 *
 */
int ConfFile::save() {
  // test code
  if ( ! this->open_write() ) {
    return -1;
  }

  this->write_line("test1");
  this->write_line("test2");
  this->write_line("test3");
  this->file.close();
  
  return this->line_count;
} // ConfFile::save()

/** virtual
 *
 */
bool ConfFile::remove() {
  log_d("remove file: \"%s\"", this->file_name);
  return SPIFFS.remove(this->file_name);
} // ConfFile::remove()

/** protected
 *
 */
bool ConfFile::open_read() {
  log_d("%s", this->file_name.c_str());

  this->file = SPIFFS.open(this->file_name, "r");
  if ( ! this->file ) {
    log_e("%s: open failed", file_name.c_str());
    return false;
  }
  this->line_count = 0;
  return true;
} // ConfFile::open_read()

/** protected
 *
 */
bool ConfFile::open_write() {
  log_d("%s", this->file_name.c_str());

  this->file = SPIFFS.open(this->file_name, "w");
  if ( ! this->file ) {
    log_e("%s: open failed", file_name.c_str());
    return false;
  }
  this->line_count = 0;
  return true;
} // ConfFile::open_write()

/** protected
 *
 */
void ConfFile::close() {
  this->file.close();
} // ConfFile::close()

/** protected
 *
 */
String ConfFile::read_line() {
  int ret = this->file.available();
  if ( ret <= 0 ) {
    log_w("ret=%d: EOF?", ret);
    return "";
  }

  String line = this->file.readStringUntil('\n');
  line.trim(); // XXX Important !!
  this->line_count++;
  log_v("%5d|%s|", line_count, line.c_str());
  return line;
} // ConfFile::read_line()

/** protected
 *
 */
String ConfFile::write_line(String line) {
  line.trim(); // XXX Important !!
  this->file.println(line);
  this->line_count++;
  log_v("%5d|%s|", line_count, line.c_str());
  return line;
} // ConfFile::write_line()
