ytani01/NixieTubeClock_IN-16/src/ConfFile_Ssid.h

/**
 * Copyright (c) 2023 Yoichi Tanibayashi
 */
#ifndef _CONFFILE_SSID_H_
#define _CONFFILE_SSID_H_

#include <map>
#include "ConfFile.h"

/**
 *
 */
class ConfFile_Ssid: public ConfFile {
 public:
  static constexpr char *FILE_NAME = (char *)"/ssid";

  std::map<std::string, std::string> ent;

  ConfFile_Ssid();
  virtual int load();
  virtual int save();
}; // class ConfFile_Ssid

#endif // _CONFFILE_SSID_H_
