ytani01/NixieTubeClock_IN-16/src/MyRtc.h

/**
 * Copyright (c) 2023 Yoichi Tanibayashi
 */
#ifndef _MY_RTC_
#define _MY_RTC_

#include <RTClib.h>
#include "commonlib.h"

extern bool Flag_enableIntr;
extern void enableIntr();
extern void disableIntr();

//#define MY_RTC RTC_DS3231
#define MY_RTC RTC_PCF8563

/**
 * set Rename super class name
 */
class MyRtc: public MY_RTC {
public:
  DateTime now(); // override

  void adjust(const DateTime &dt);
  void adjust(struct tm *tm);
}; // class MyRtc

#endif // _MY_RTC_
