ytani01/NixieTubeClock_IN-16/src/NixieElement.cpp

/**
 * Copyright (c) 2023 Yoichi Tanibayashi
 */
#include "NixieElement.h"

void NixieElement::setup(uint8_t pin) {
  this->set_pin(pin);

  this->set_brightness(0);
  this->_on = false;
}

/**
 *
 */
brightness_t NixieElement::max_brightness() {
  return this->_max_brightness;
} // NixieElement::max_brightness()

/**
 *
 */
brightness_t NixieElement::set_max_brightness(brightness_t bri) {
  this->_max_brightness = bri;
  return this->_max_brightness;
} // NixieElement::set_max_brightness()

/**
 *
 */
brightness_t NixieElement::set_brightness_to_max() {
  this->_brightness = this->_max_brightness;
  return this->_brightness;
}

/**
 *
 */
brightness_t NixieElement::set_brightness(brightness_t brightness) {
  this->_brightness = brightness;
  return this->_brightness;
} // NixieElement::set_brightness()

/**
 *
 */
brightness_t NixieElement::inc_brightness() {
  if ( this->_brightness < this->_max_brightness ) {
    this->_brightness++;
  }
  return this->_brightness;
}
brightness_t NixieElement::dec_brightness() {
  if ( this->_brightness > 0 ) {
    this->_brightness--;
  }
  return this->_brightness;
}
unsigned int NixieElement::brightness() {
  return this->_brightness;
}

void NixieElement::set_pin(uint8_t pin) {
  this->_pin = pin;
}
uint8_t NixieElement::get_pin() {
  return this->_pin;
}

void NixieElement::on() {
  this->_on = true;
}
void NixieElement::off() {
  this->_on = false;
}
boolean NixieElement::is_on() {
  return this->_on;
}
