ytani01/NixieTubeClock_IN-16/tests/clock02/Task_Button.cpp

/**
 * Copyright (c) 2023 Yoichi Tanibayashi
 */
#include "Task_Button.h"

static QueueHandle_t outQue = (QueueHandle_t)NULL; // for static function

/**
 *
 */
Task_Button::Task_Button(String btn_name, uint8_t pin,
                         uint32_t stack_size, UBaseType_t priority,
                         UBaseType_t core)
  : Task(btn_name + "Task", stack_size, priority, core)
{
  this->btn_name = btn_name;
  this->pin = pin;

  this->btn = new Button(this->btn_name, this->pin, this->intr_hdr);

  if ( outQue == NULL ) {
    this->_out_que = xQueueCreate(Task_Button::Q_SIZE,
                                  sizeof(ButtonInfo_t));
    if ( this->_out_que == NULL ) {
      log_e("create out_que: failed .. HALT");
      while (true) { // HALT
        delay(1);
      }
    }
    outQue = this->_out_que;
    log_i("new Que: %X", outQue);
  } else {
    this->_out_que = outQue;
    log_i("reuse Que: %X", outQue);
  }
} // Task_Button::Task_Button

/**
 *
 */
void Task_Button::setup() {
  log_d("%s", this->btn_name.c_str());
} // Task_Button::setup()

/**
 *
 */
void Task_Button::loop() {
  if ( this->btn->get() ) {
    portBASE_TYPE ret = xQueueSend(outQue,
                                   (void *)&(this->btn->info), 10);
    if ( ret == pdPASS ) {
      log_d("que < %s", this->btn->toString().c_str());
    } else {
      log_w("que X< %s: ret=%d", this->btn->toString().c_str(), ret);
    }
  }
  delay(10);
} // Task_Button::loop()

/** [static]
 *
 */
void IRAM_ATTR Task_Button::intr_hdr(void *btn_obj) {
  static unsigned long __prev_ms = 0;
  unsigned long __cur_ms = millis();

  // check debounce
  if ( __cur_ms - __prev_ms < Button::DEBOUNCE ) {
    return;
  }
  __prev_ms = __cur_ms;

  // update button status
  Button *btn = static_cast<Button *>(btn_obj);
  if ( ! btn->get() ) {
    return;
  }
  isr_log_d("btn->info.name=%s", btn->info.name);

  // send to queue
  static BaseType_t xHigherPriorityTaskWoken;
  xHigherPriorityTaskWoken = pdFALSE;
  portBASE_TYPE ret = xQueueSendFromISR(outQue,
                                        (void *)&(btn->info),
                                        &xHigherPriorityTaskWoken);
  if ( ret == pdPASS) {
    isr_log_d("que < %s", btn->toString().c_str());
  } else {
    isr_log_e("send que failed: %s: ret=%d", btn->toString().c_str(), ret);
  }
  
  if ( xHigherPriorityTaskWoken ) {
    isr_log_d("portYIELD_FROM_ISR()");
    portYIELD_FROM_ISR();
  }
} // Task_Button::intr_hdr()

/**
 *
 */
portBASE_TYPE Task_Button::get(ButtonInfo_t *btn_info) {
  portBASE_TYPE ret = xQueuePeek(outQue, (void *)btn_info, 1000);
  if ( ret == pdPASS ) {
    if ( String(btn_info->name) == this->btn_name ) {
      ret = xQueueReceive(outQue, (void *)btn_info, 0);
      log_d("%s:que > %s", this->btn_name.c_str(),
            Button::info2String(btn_info).c_str());
    } else {
      log_d("%s:que >X %s", this->btn_name.c_str(), 
            Button::info2String(btn_info).c_str());
      ret = pdFALSE;
      delay(2);
    }
  }
  return ret;
} // Task_Button::get()

/**
 * defulat callback
 */
static void _button_cb(ButtonInfo_t *btn_info) {
  log_i("%s", Button::info2String(btn_info).c_str());
} // _button_cb()

/**
 *
 */
Task_ButtonWatcher::Task_ButtonWatcher(String btn_name, uint8_t pin,
                             void (*cb)(ButtonInfo_t *btn_info),
                             uint32_t stack_size,
                             UBaseType_t priority,
                             UBaseType_t core)
  : Task(btn_name + "Watcher", stack_size, priority, core)
{
  this->_btn_name = btn_name;
  this->_pin = pin;
  this->_cb = cb;
  this->_stack_size = stack_size;
  this->_priority = priority;
  this->_core = core;

  if ( cb == NULL ) {
    this->_cb = _button_cb;
  }

  this->_btn_task=NULL;
} // Task_ButtonWatcher::Task_ButtonWatcher()

/**
 *
 */
ButtonInfo_t *Task_ButtonWatcher::get_btn_info() {
  return &(this->_btn_task->btn->info);
} // Task_ButtonWatcher::get_btn_info()

/**
 *
 */
void Task_ButtonWatcher::setup() {
  log_i("%s", this->conf.name);

  this->_btn_task = new Task_Button(this->_btn_name,
                                    this->_pin,
                                    this->_stack_size,
                                    this->_priority,
                                    this->_core);
  this->_btn_task->start();
} // Task_ButtonWatcher::setup()

/**
 *
 */
void Task_ButtonWatcher::loop() {
  if ( this->_btn_task == NULL ) {
    return;
  }
  
  ButtonInfo_t btn_info;
  portBASE_TYPE ret = this->_btn_task->get(&btn_info);
  if ( ret == pdPASS ) {
      (*(this->_cb))(&btn_info);
  }
} // Task_ButtonWatcher::loop()
