ytani01/NixieTubeClock_IN-16/tests/LOLIN_D32/test3-mode/ModeA.cpp

/**
 * Copyright (c) 2023 Yoichi Tanibayashi
 */
#include "ModeA.h"

ModeA::ModeA(): Mode() {
}

void ModeA::loop() {
  log_d("%s: class %s: name: %s",
        SysClock::now_str(),
        __CLASS_NAME__.c_str(), this->name.c_str());
  delay(5000);
}
