ytani01/NixieTubeClock_IN-16/tests/LOLIN_D32/test5-net/ConfFile_Ssid.cpp

/**
 * Copyright (c) 2023 Yoichi Tanibayashi
 */
#include "ConfFile_Ssid.h"

/** constructor
 *
 */
ConfFile_Ssid::ConfFile_Ssid()
  : ConfFile(String(ConfFile_Ssid::FILE_NAME)) {
} // ConfFile_Ssid::ConfFile_Ssid()

/** virtual
 *
 * @return number of entries
 */
int ConfFile_Ssid::load() {
  log_d("");
  if ( this->open_read() < 0 ) {
    return -1;
  }

  this->ent.clear();

  while ( this->file.available() ) {
    String ssid = this->read_line();
    String pw = this->read_line();
    log_d("load|%s|%s|", ssid.c_str(), pw.c_str());

    this->ent[ssid.c_str()] = pw.c_str();
  } // while(this->file.available())

  this->close();

  for (auto it: this->ent) {
  //for (auto it=this->ent.begin(); it != ent.end(); it++) {
    log_d("ent|%s|%s|", (it.first).c_str(), (it.second).c_str());
  }
  return this->ent.size();
} // ConfFile_Ssid::load()

/** virtual
 * 
 * @return num of entries
 */
int ConfFile_Ssid::save() {
  if ( this->open_write() < 0 ) {
    return -1;
  }

  for (auto it=this->ent.begin(); it != ent.end(); it++) {
    String ssid = (it->first).c_str();
    String pw = (it->second).c_str();
    if ( pw.length() == 0 ) {
      log_w("|%s|%s| .. ignored", ssid.c_str(), pw.c_str());
      continue;
    }
    log_d("|%s|%s|", ssid.c_str(), pw.c_str());
    
    this->write_line(ssid);
    this->write_line(pw);
  }
  this->close();

  return this->ent.size();
} // ConfFile_Ssid::save()
