ytani01/NixieTubeClock_IN-16/(commit log)

2023-10-02 FIX: RTC setting manually
    [ConfWifi.cpp, Effect.cpp, ModeBase.cpp, ModeClock.cpp, ModeSetClock.cpp, ModeSetClock.h, NetMgr.cpp, NixieArray.cpp]
2023-10-06 UPD: directory tree
    [Bottom_Drawing_0821.dxf, Bottom_Drawing_0827.dxf, Bottom_Rubber_Foot.dxf, Bottom_acrylic_0819.dxf, IN-16_6digit_MCU_Base.dxf, IN-16_6digit_Nixie_Base.dxf, IN-16_6digit_PCB_drawing.dxf, IN-16_6digit_PCB_outline.dxf]
2023-10-06 UPD: README.md: Arduino IDE Settings
2023-10-06 UPD: Added correction for fade effect when darkening
    [ModeClock.cpp, NixieEffect.cpp]
2023-10-13 UPD: LOLIN_D32/test1-button
2023-10-28 ADD: NixieTubeClock-2: Btn0-double click = xfade switch
2023-10-30 UPD: Setclock Boot Reboot etc.
    [Mode.h, ModeBoot.cpp, ModeReboot.cpp, ModeSetclock.cpp, NixieEffect.cpp, NixieTube.cpp, Task_NixieTubeArray.cpp, src.ino]
2023-11-02 UPD: check memory leak
    [Task_NixieTubeArray.cpp, commonlib.cpp, commonlib.h]
2023-11-04 FIX: adjust log message
    [src.ino]
2023-11-06 UPD: tune button timing
